pfory/meteo/WH1080/dsh.833-137.1.pdf

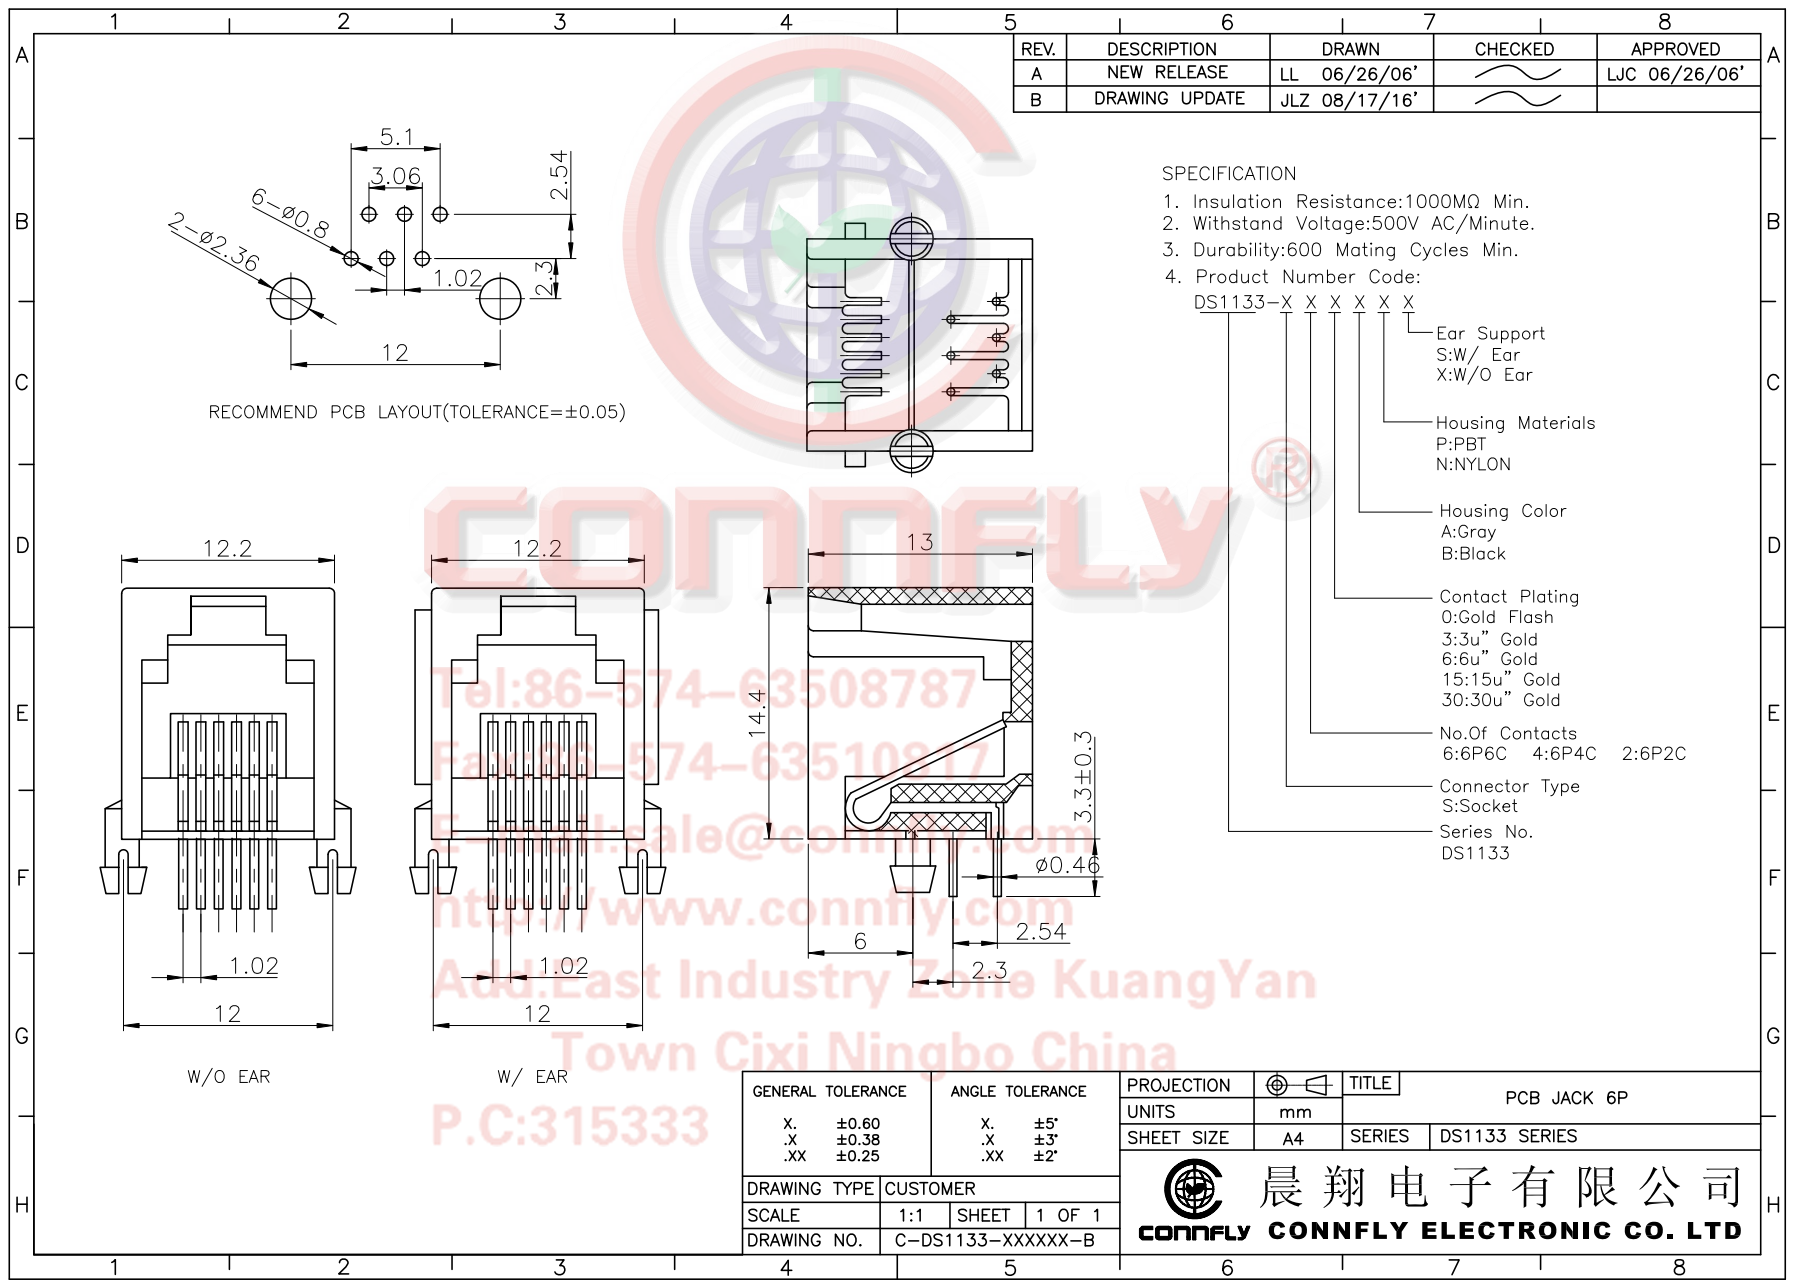
[picture p4: page 1]
