pfory/meteo/WH1080/schema.brd

## EAGLE design WH1080/schema.brd (2024-05-01)

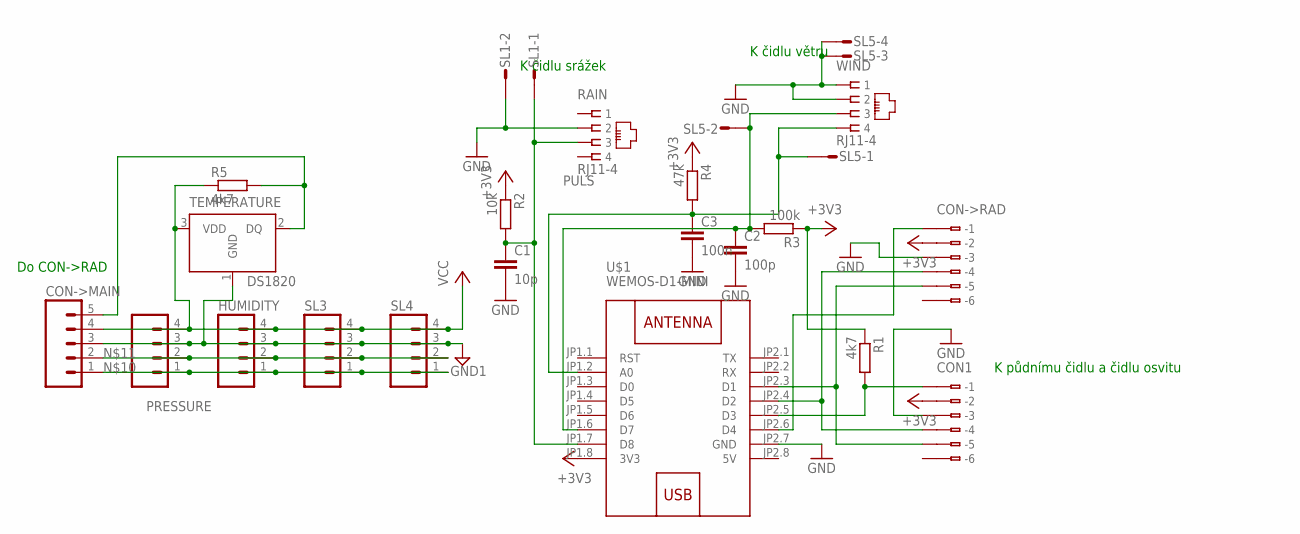
[picture p5: schematic schema.sch]

Parts:
C1: 10p; C025-024X044
C2: 100p; C025-024X044
C3: 100n; C025-024X044
CON1: 233-506
CON->MAIN: M05; 05P
CON->RAD: 233-506
HUMIDITY: M04; 04P
PRESSURE: M04; 04P
R1, R5: 4k7; 0204/7
R2: 10k; 0204/7
R3: 100k; 0204/7
R4: 47k; 0204/7
RAIN: RJ11-4
SL1: M02S; 02P
SL3, SL4: M04; 04P
SL5: M04S; 04P
TEMPERATURE: DS1820; TO-92
U$1: WEMOS-D1-MINI
WIND: RJ11-4

Connections:
5V: U$1.JP2.8 (5V)
+3V3: CON1.B2 (B-2), CON->RAD.B2 (B-2), R1.1, R2.1, R3.1, R4.1, U$1.JP1.8 (3V3)
GND: C1.2, C2.2, C3.2, CON1.B3 (B-3), CON->RAD.B3 (B-3), RAIN.2, SL1.2, SL5.3, SL5.4, U$1.JP2.7 (GND), WIND.1, WIND.2
GND1: CON->MAIN.3, HUMIDITY.3, PRESSURE.3, SL3.3, SL4.3, TEMPERATURE.1 (GND)
unnamed: CON->MAIN.5, R5.2, TEMPERATURE.2 (DQ)
unnamed: CON->MAIN.1, HUMIDITY.1, PRESSURE.1, SL3.1, SL4.1
unnamed: CON->MAIN.2, HUMIDITY.2, PRESSURE.2, SL3.2, SL4.2
unnamed: CON1.B1 (B-1), R1.2, U$1.JP2.5 (D3)
unnamed: CON->RAD.B1 (B-1), U$1.JP2.6 (D4)
PULS: C1.1, R2.2, RAIN.3, SL1.1, U$1.JP1.7 (D8)
RYCHLOST: C2.1, R3.2, SL5.2, U$1.JP1.6 (D7), WIND.3
SCL: CON1.B5 (B-5), CON->RAD.B5 (B-5), U$1.JP2.3 (D1)
SDA: CON1.B4 (B-4), CON->RAD.B4 (B-4), U$1.JP2.4 (D2)
SMER: C3.1, R4.2, SL5.1, U$1.JP1.2 (A0), WIND.4
VCC: CON->MAIN.4, HUMIDITY.4, PRESSURE.4, R5.1, SL3.4, SL4.4, TEMPERATURE.3 (VDD)

Notes on the sheet:
K čidlu srážek
K čidlu větru
Do CON->RAD
K půdnímu čidlu a čidlu osvitu

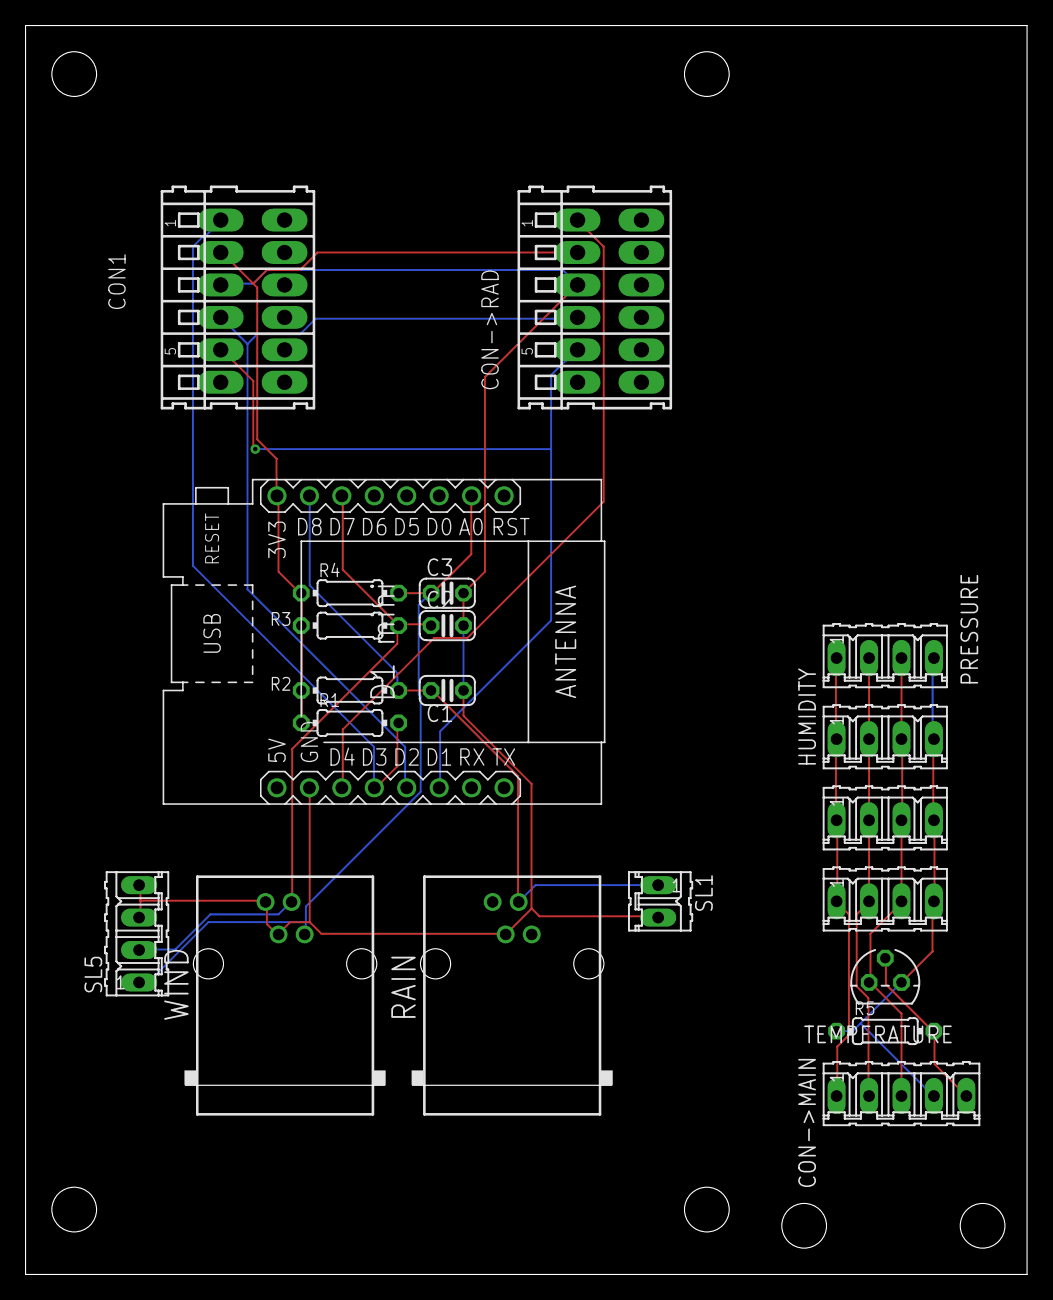
[picture p6: board schema.brd from above]

Board: 2 copper layers, 78.4 x 97.8 mm, 21 parts (0 on the bottom side), 14 nets.
