pfory/meteo/senzory.brd

## EAGLE design senzory.brd (2019-08-12)

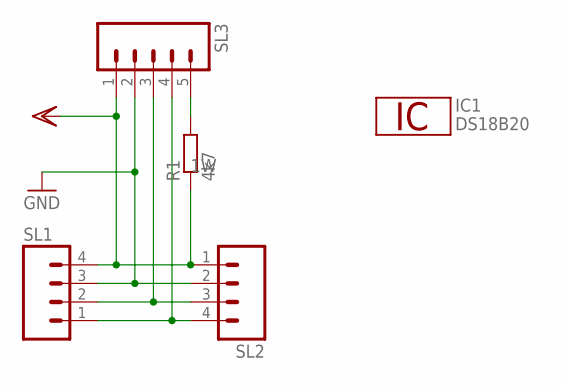
[picture p7: schematic senzory.sch]

Parts:
IC1: DS18B20; TO92-
R1: 4k7; 0204/7
SL1, SL2: M04; 04P
SL3: M05; 05P

Connections:
1W: IC1.2 (1W), R1.2, SL3.5
GND: IC1.1 (GND), SL1.3, SL2.2, SL3.2
SCL: SL1.2, SL2.3, SL3.3
SDA: SL1.1, SL2.4, SL3.4
VDD: IC1.3 (VDD), R1.1, SL1.4, SL2.1, SL3.1

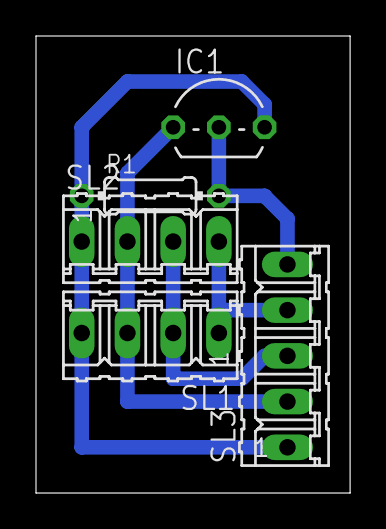
[picture p8: board senzory.brd from above]

Board: 2 copper layers, 17.4 x 25.4 mm, 5 parts (0 on the bottom side), 5 nets.
