pfory/meteo/(commit log)

2018-01-22 oprava teplot 0 až -1 v html
2018-07-11 v0.64 - uprava casovani - vyreseni problemu s restartem
    [Meteo.ino]
2019-06-20 - vynuceny reset pres MQTT
    [Meteo.ino]
2019-07-21 reset kdyz nemeri cidla na i2c
    [Meteo.ino]
2019-08-28 + diagnostika programového resetu, stav 998 a 999
    [Meteo.ino]
2019-10-10 1.95 modernizace kodu
    [Configuration.h]
2019-10-10 send delay 1 minuta
    [Configuration.h]
2020-05-06 1.98 - tlak na in-pocasi v hPa
    [Configuration.h]
2021-01-21 - nepouzivane define z configu
    [Configuration.h]
2021-01-21 + double reset detector + ip z dhcp uprava wifi connectoru na novy tvar
    [Configuration.h]
2021-01-21 uprava nazvu
    [Configuration.h]
2021-11-30 v 2.10 + config
    [Configuration.h]
2023-08-07 změna intervalu měření z 5 sekund na 30 sekund
    [Configuration.h]
2023-08-07 kosmetické změny kódu
    [Configuration.h]
2023-12-10 + sensor vlhkosti SHT40
    [Configuration.h]
2024-01-22 pridani dat do vystupu na inPocasi a zmena formatu dat
    [Configuration.h]
2024-01-23 + data vítr a srážky pro in-pocasi.cz
    [Configuration.h]
2024-01-26 nova meteo stanice
    [delic pro meteo.ods, schema.brd, schema.sch]
2024-03-21 vyroba DPS
    [Configuration.h, schema.brd, schema.sch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]
2024-04-10 změna odporu pro dělič směru větru
    [schema.brd, schema.sch]
2024-04-15 filtr srazky
    [Configuration.h]
2024-04-17 zmena mqtt_base
    [Configuration.h]
2024-05-07 odesilani pulsu srazek jen pokud > 0
    [Configuration.h]
2024-06-26 ostrá verze
    [Configuration.h]
